MissouriMRDT/ESCBoard_Hardware/README.md

# MotorController_Hardware
New motor controllers developed for 2022 competition
Based on VESC 4.12 Motor Controllers
