MissouriMRDT/ESCBoard_Hardware/Hardware/Mocos_2021/Mocos_2021.kicad_pcb

## KiCad design Hardware/Mocos_2021/Mocos_2021.kicad_pcb (2021-08-28)

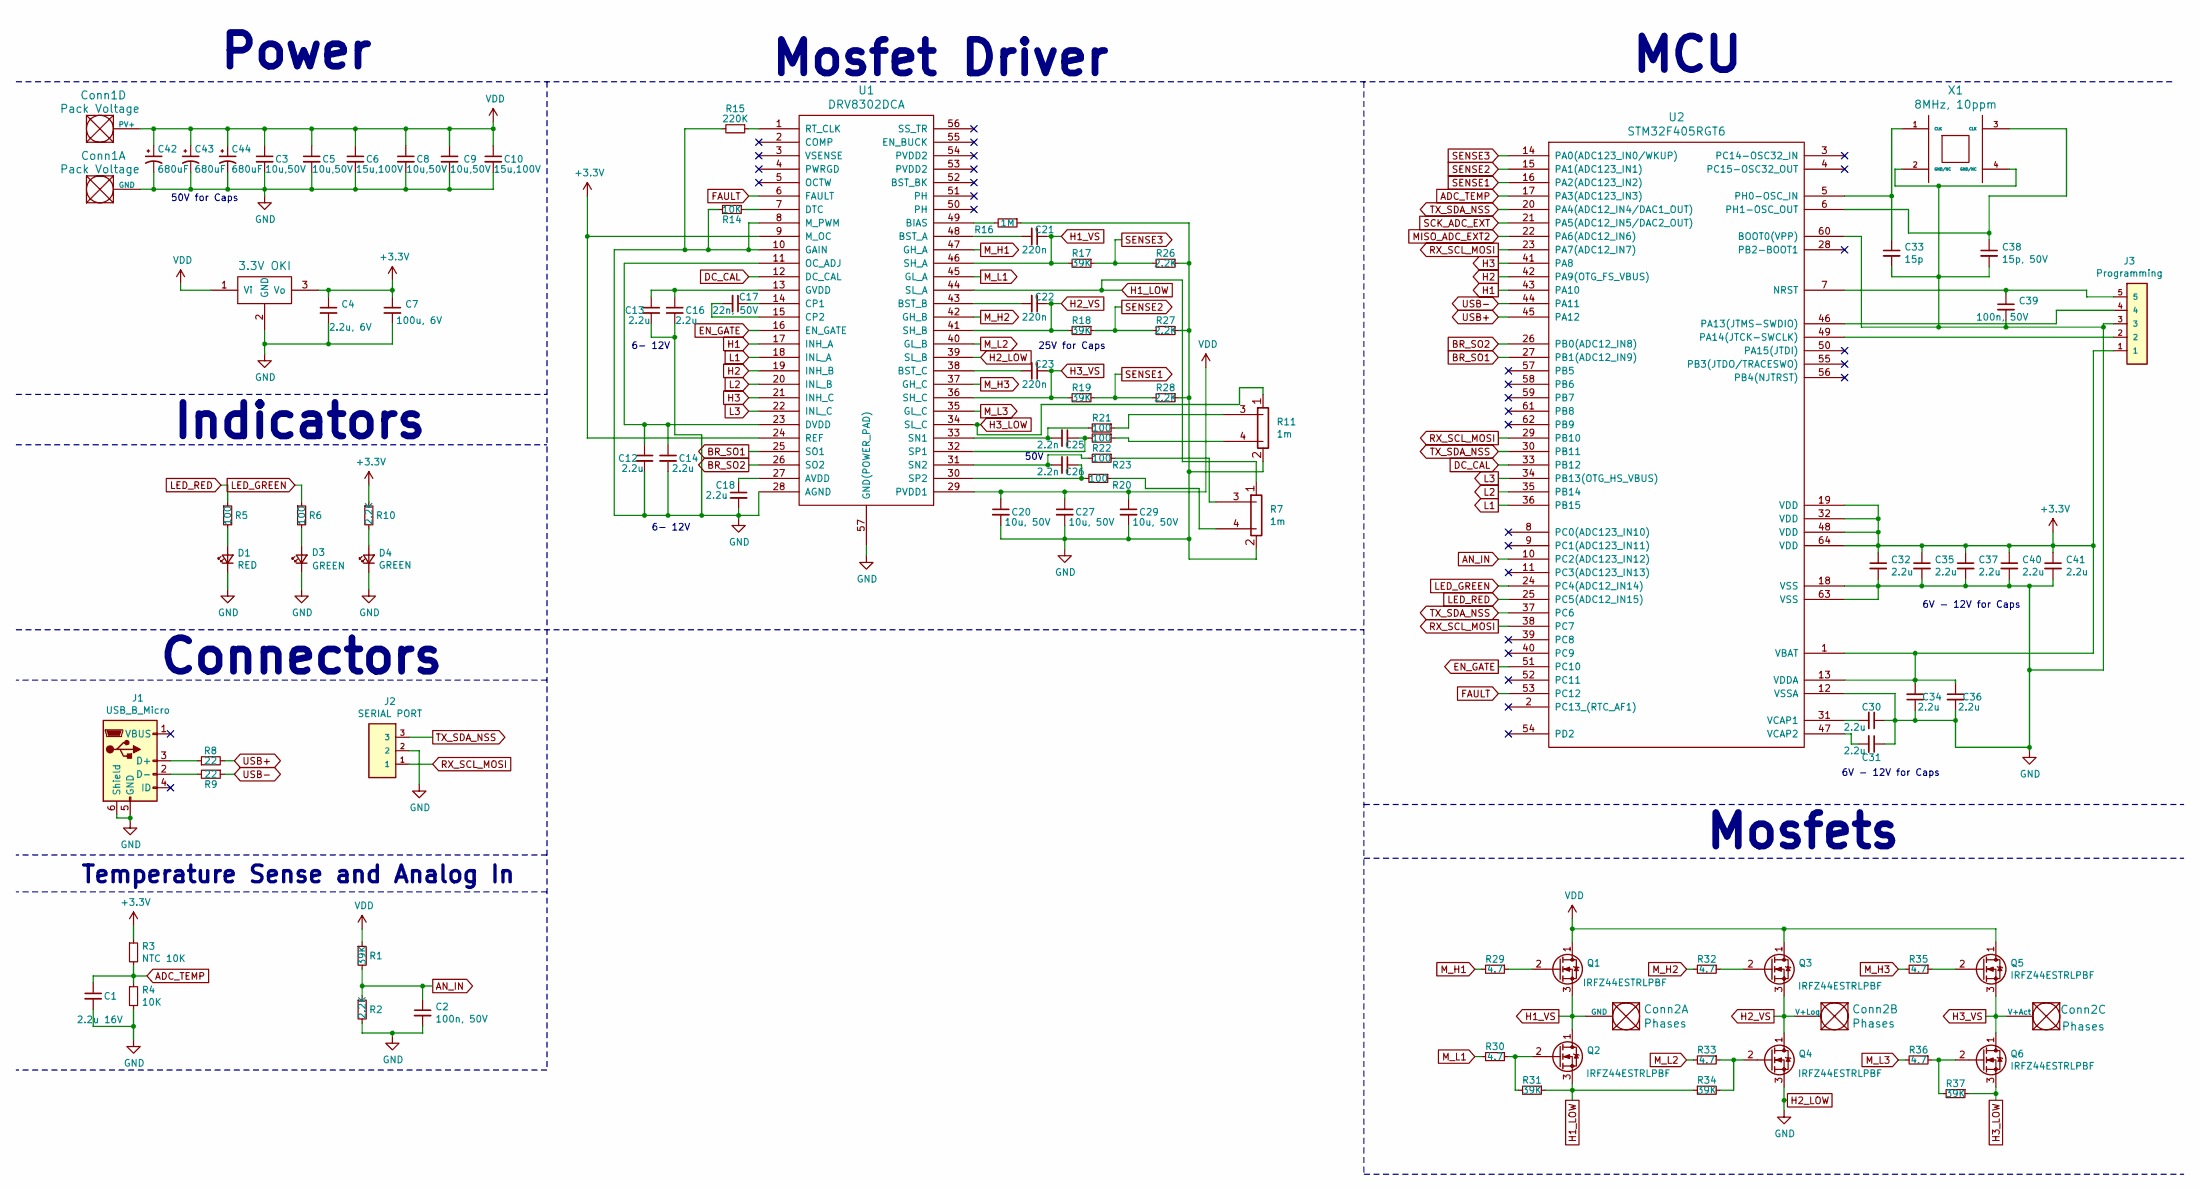
[picture p8: schematic Mocos_2021.sch, Vesc Motor Controller Rework]

Parts:
C1: 2.2u 16V; C_0402_1005Metric_Pad0.74x0.62mm_HandSolder
C2, C39: 100n, 50V; C_0603_1608Metric_Pad1.08x0.95mm_HandSolder
C3, C5, C8, C9: 10u,50V; C_1210_3225Metric_Pad1.33x2.70mm_HandSolder
C4: 2.2u, 6V; C_0402_1005Metric_Pad0.74x0.62mm_HandSolder
C6, C10: 15u,100V; C_2220_5650Metric_Pad1.97x5.40mm_HandSolder
C7: 100u, 6V; C_0805_2012Metric_Pad1.18x1.45mm_HandSolder
C12, C13, C14, C16, C18, C30, C31, C32, C34, C35, C36, C37, C40, C41: 2.2u; C_0402_1005Metric_Pad0.74x0.62mm_HandSolder
C17: 22n, 50V; C_0402_1005Metric_Pad0.74x0.62mm_HandSolder
C20, C27, C29: 10u, 50V; C_1210_3225Metric_Pad1.33x2.70mm_HandSolder
C21, C22, C23: 220n; C_0805_2012Metric_Pad1.18x1.45mm_HandSolder
C25, C26: 2.2n; C_0402_1005Metric_Pad0.74x0.62mm_HandSolder
C33: 15p; C_0603_1608Metric_Pad1.08x0.95mm_HandSolder
C38: 15p, 50V; C_0603_1608Metric_Pad1.08x0.95mm_HandSolder
C42, C43, C44: 680uF; CP_Radial_D16.0mm_P7.50mm
Conn1: Pack Voltage; Anderson_2_Horizontal_Side_by_Side_PV
Conn2: Phases; Anderson_3_Horizontal_Side_by_Side
D1: RED; LED_0603_1608Metric_Pad1.05x0.95mm_HandSolder
D3, D4: GREEN; LED_0603_1608Metric_Pad1.05x0.95mm_HandSolder
J1: USB_B_Micro; MOLEX_47346-0001
J2: SERIAL PORT; MOLEX_uF_S_03_Horizontal
J3: Programming; MOLEX_uF_S_05_Horizontal
Q1, Q2, Q3, Q4, Q5, Q6: IRFZ44ESTRLPBF
R1, R17, R18, R19, R31, R34, R37: 39K; R_0603_1608Metric_Pad0.98x0.95mm_HandSolder
R2, R10, R26, R27, R28: 2.2K; R_0603_1608Metric_Pad0.98x0.95mm_HandSolder
R3: NTC 10K; R_0603_1608Metric_Pad0.98x0.95mm_HandSolder
R4, R14: 10K; R_0603_1608Metric_Pad0.98x0.95mm_HandSolder
R5, R6, R20, R21, R22, R23: 100; R_0603_1608Metric_Pad0.98x0.95mm_HandSolder
R7, R11: 1m; WSLP2726
R8, R9: 22; R_0603_1608Metric_Pad0.98x0.95mm_HandSolder
R15: 220K; R_0603_1608Metric_Pad0.98x0.95mm_HandSolder
R16: 1M; R_0603_1608Metric_Pad0.98x0.95mm_HandSolder
R29, R30, R32, R33, R35, R36: 4.7; R_0603_1608Metric_Pad0.98x0.95mm_HandSolder
U1: DRV8302DCA; TSSOP-56-PP
U2: STM32F405RGT6; lqfp64_pad_mod
U3: 3.3V OKI; OKI_Horizontal
X1: 8MHz, 10ppm; Crystal_5x3mm

Connections:
+3V3: C4.1, C7.1, C32.1, C34.2, C35.1, C36.1, C37.1, C40.1, C41.1, J3.1, R3.1, R10.1, U1.9 (M_OC), U1.24 (REF), U2.1 (VBAT), U2.13 (VDDA), U2.19 (VDD), U2.32 (VDD), U2.48 (VDD), U2.64 (VDD), U3.3 (Vo)
ADC_TEMP: C1.1, R3.2, R4.1, U2.17 (PA3(ADC123_IN3))
AN_IN: C2.1, R1.2, R2.1, U2.10 (PC2(ADC123_IN12))
BR_SO1: U1.25 (SO1), U2.27 (PB1(ADC12_IN9))
BR_SO2: U1.26 (SO2), U2.26 (PB0(ADC12_IN8))
DC_CAL: U1.12 (DC_CAL), U2.33 (PB12)
EN_GATE: U1.16 (EN_GATE), U2.51 (PC10)
FAULT: U1.6 (FAULT), U2.53 (PC12)
H1: U1.17 (INH_A), U2.43 (PA10)
H1_LOW: Q2.3 (S), R7.1, R31.1, R34.1, U1.44 (SL_A)
H1_VS: C21.1, Conn2.1 (GND), Q1.3 (S), Q2.1 (D), R17.2, U1.46 (SH_A)
H2: U1.19 (INH_B), U2.42 (PA9(OTG_FS_VBUS))
H2_LOW: C1.2, C2.2, C3.2, C4.2, C5.2, C6.2, C7.2, C8.2, C9.2, C10.2, C12.2, C13.2, C14.2, C16.2, C18.2, C20.2, C27.2, C29.2, C30.1, C31.1, C32.2, C33.2, C34.1, C35.2, C36.2, C37.2, C38.2, C39.2, C40.2, C41.2, C42.2, C43.2, C44.2, Conn1.1 (GND), D1.1 (K), D3.1 (K), D4.1 (K), J1.5 (GND), J1.6 (Shield), J2.2, J3.3, Q4.3 (S), R2.2, R4.2, R7.2, R11.2, R14.2, R15.2, R16.1, R26.1, R27.1, R28.1, U1.8 (M_PWM), U1.10 (GAIN), U1.28 (AGND), U1.39 (SL_B), U1.57 (GND(POWER_PAD)), U2.12 (VSSA), U2.18 (VSS), U2.60 (BOOT0(VPP)), U2.63 (VSS), U3.2 (GND), X1.2 (GND/NC), X1.4 (GND/NC)
H2_VS: C22.1, Conn2.2 (V+Log), Q3.3 (S), Q4.1 (D), R18.2, U1.41 (SH_B)
H3: U1.21 (INH_C), U2.41 (PA8)
H3_LOW: Q6.3 (S), R11.1, R37.1, U1.34 (SL_C)
H3_VS: C23.1, Conn2.3 (V+Act), Q5.3 (S), Q6.1 (D), R19.2, U1.36 (SH_C)
L1: U1.18 (INL_A), U2.36 (PB15)
L2: U1.20 (INL_B), U2.35 (PB14)
L3: U1.22 (INL_C), U2.34 (PB13(OTG_HS_VBUS))
LED_GREEN: R6.1, U2.24 (PC4(ADC12_IN14))
LED_RED: R5.1, U2.25 (PC5(ADC12_IN15))
M_H1: R29.2, U1.47 (GH_A)
M_H2: R32.2, U1.42 (GH_B)
M_H3: R35.2, U1.37 (GH_C)
M_L1: R30.2, U1.45 (GL_A)
M_L2: R33.2, U1.40 (GL_B)
M_L3: R36.2, U1.35 (GL_C)
unnamed: C12.1, C14.1, U1.11 (OC_ADJ), U1.23 (DVDD)
unnamed: C13.1, C16.1, U1.13 (GVDD)
unnamed: C17.1, U1.14 (CP1)
unnamed: C17.2, U1.15 (CP2)
unnamed: C18.1, U1.27 (AVDD)
unnamed: C21.2, U1.48 (BST_A)
unnamed: C22.2, U1.43 (BST_B)
unnamed: C23.2, U1.38 (BST_C)
unnamed: C25.1, R22.2, U1.32 (SP1)
unnamed: C25.2, R21.2, U1.33 (SN1)
unnamed: C26.1, R20.2, U1.30 (SP2)
unnamed: C26.2, R23.2, U1.31 (SN2)
unnamed: C30.2, U2.31 (VCAP1)
unnamed: C31.2, U2.47 (VCAP2)
unnamed: C33.1, U2.5 (PH0-OSC_IN), X1.1 (CLK)
unnamed: C38.1, U2.6 (PH1-OSC_OUT), X1.3 (CLK)
unnamed: C39.1, J3.5, U2.7 (NRST)
unnamed: D1.2 (A), R5.2
unnamed: D3.2 (A), R6.2
unnamed: D4.2 (A), R10.2
unnamed: J1.2 (D-), R9.2
unnamed: J1.3 (D+), R8.1
unnamed: J3.2, U2.49 (PA14(JTCK-SWCLK))
unnamed: J3.4, U2.46 (PA13(JTMS-SWDIO))
unnamed: Q1.2 (G), R29.1
unnamed: Q2.2 (G), R30.1, R31.2
unnamed: Q3.2 (G), R32.1
unnamed: Q4.2 (G), R33.1, R34.2
unnamed: Q5.2 (G), R35.1
unnamed: Q6.2 (G), R36.1, R37.2
unnamed: R11.3, R21.1
unnamed: R11.4, R22.1
unnamed: R14.1, U1.7 (DTC)
unnamed: R15.1, U1.1 (RT_CLK)
unnamed: R16.2, U1.49 (BIAS)
unnamed: R7.4, R20.1
unnamed: R7.3, R23.1
RX_SCL_MOSI: J2.1, U2.23 (PA7(ADC12_IN7)), U2.29 (PB10), U2.38 (PC7)
SENSE1: R19.1, R28.2, U2.16 (PA2(ADC123_IN2))
SENSE2: R18.1, R27.2, U2.15 (PA1(ADC123_IN1))
SENSE3: R17.1, R26.2, U2.14 (PA0(ADC123_IN0/WKUP))
TX_SDA_NSS: J2.3, U2.20 (PA4(ADC12_IN4/DAC1_OUT)), U2.30 (PB11), U2.37 (PC6)
USB+: R8.2, U2.45 (PA12)
USB-: R9.1, U2.44 (PA11)
VDD: C3.1, C5.1, C6.1, C8.1, C9.1, C10.1, C20.1, C27.1, C29.1, C42.1, C43.1, C44.1, Conn1.4 (PV+), Q1.1 (D), Q3.1 (D), Q5.1 (D), R1.1, U1.29 (PVDD1), U3.1 (Vi)

Notes on the sheet:
50V for Caps
6V - 12V for Caps
6- 12V
25V for Caps
50V
Power
Mosfet Driver
MCU
Mosfets
Indicators
Connectors
Temperature Sense and Analog In

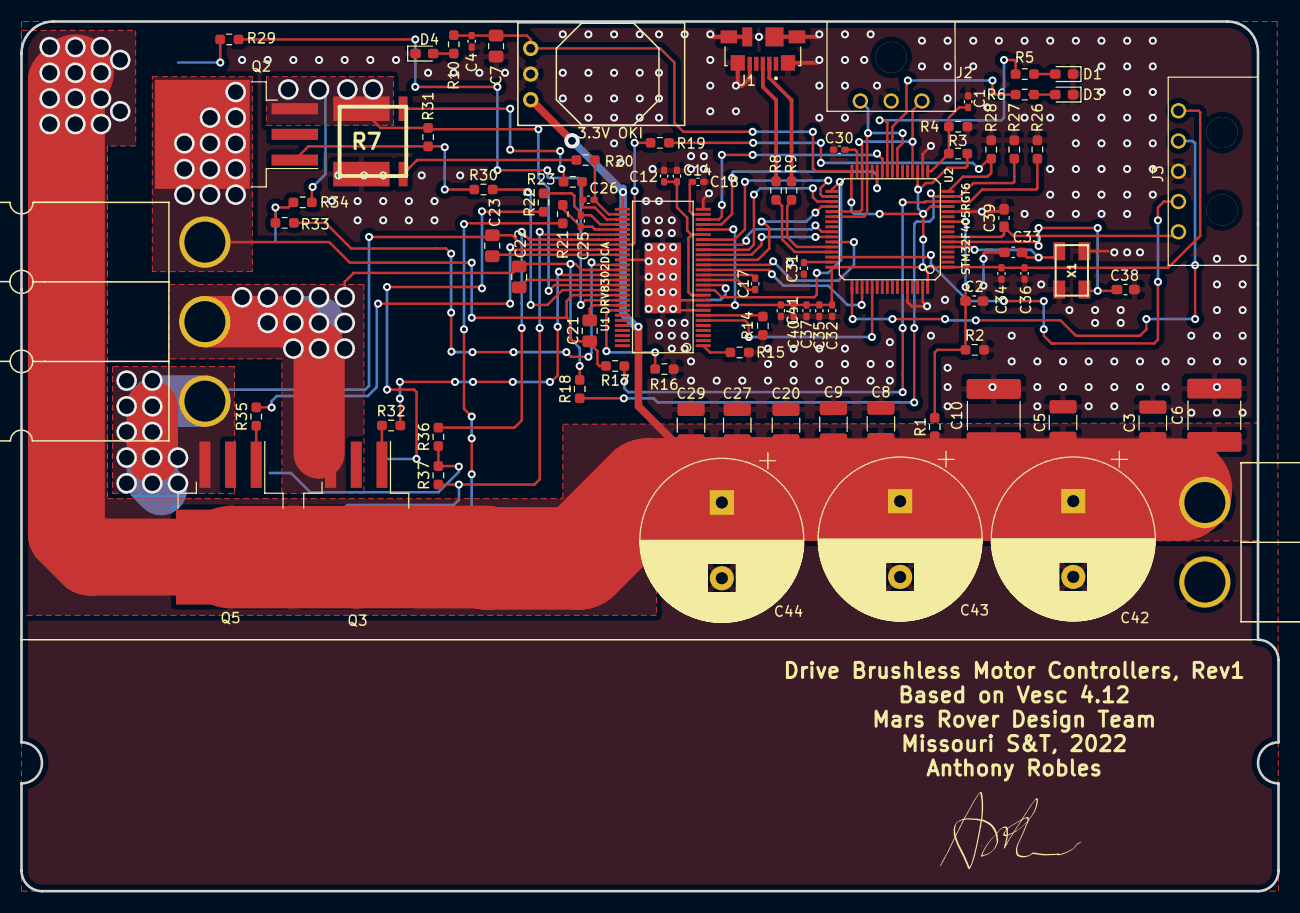
[picture p9: board Mocos_2021.kicad_pcb from above]

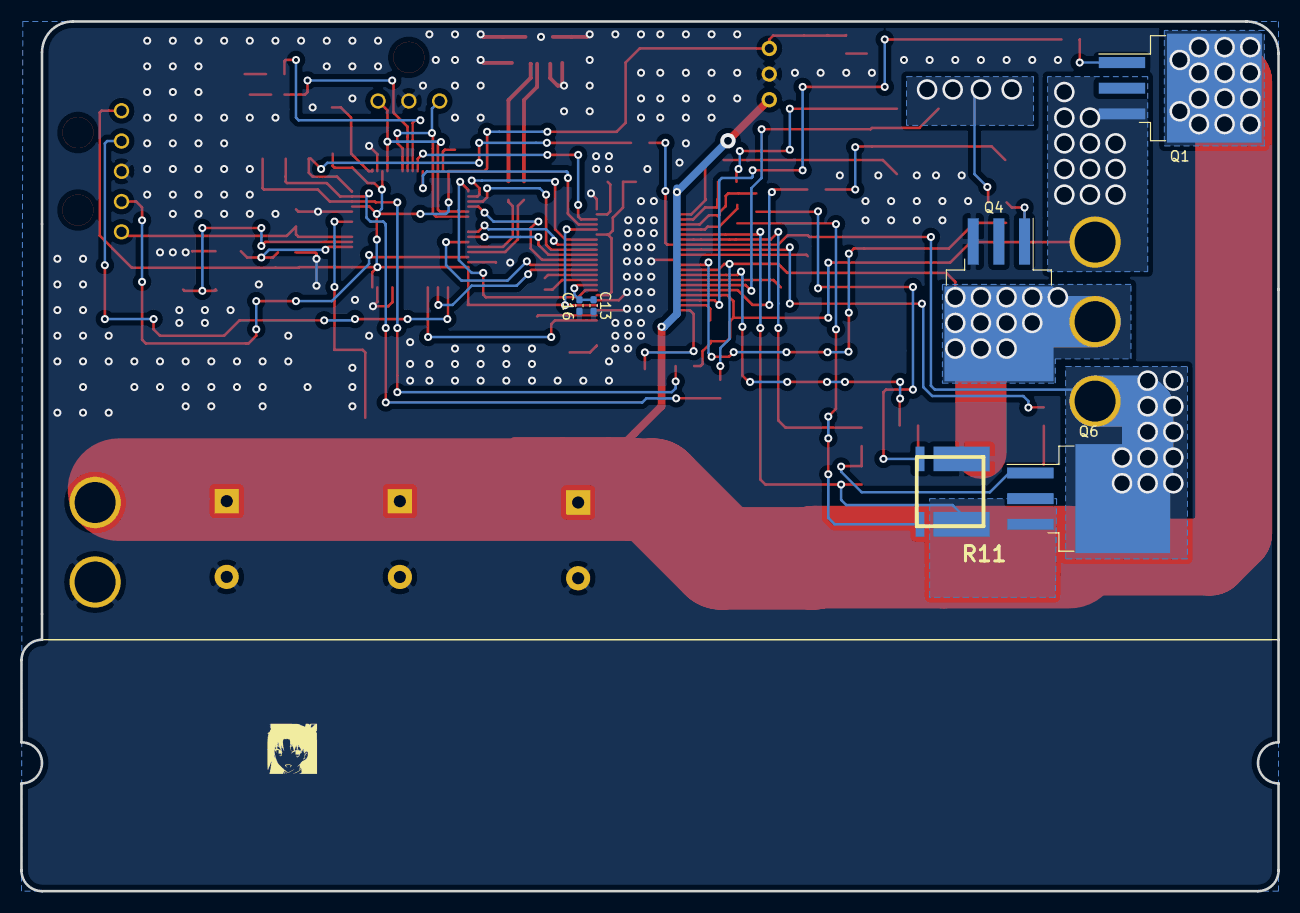
[picture p10: board Mocos_2021.kicad_pcb from below]

Board: 2 copper layers, 124.5 x 86.1 mm, 90 parts (6 on the bottom side), 73 nets.
