MissouriMRDT/ESCBoard_Hardware/(commit log)

2020-09-11 created project
    [ESC_Hardware.kicad_pcb, ESC_Hardware.sch]
2020-10-09 Added Libraries, Began Microcontroller sheet
    [ESCBoard_01.sch, ESC_Hardware.sch]
2020-10-12 finished schematic
    [CAN.sch, ESCBoard_02.sch, ESCBoard_03.sch]
2021-03-19 Added Rev4.1 for reference
    [BLDC4.12_BOM.ods, BLDC_4-2021-02-16-14-32-30.sch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]
2021-08-18 Added Schematic and working on Layout
    [BLDC4.12_BOM.ods, BLDC_4-2021-02-16-14-32-30.sch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]
2021-08-19 Added footprints to board
    [Mocos_2021.sch]
2021-08-21 Finished STM32 Layout
    [Mocos_2021.kicad_pcb, Mocos_2021.sch]
2021-08-21 Added 3.3V Oki for cleaner layout
    [Mocos_2021.kicad_pcb, Mocos_2021.sch]
2021-08-24 Retraced the entire VDD Net and readjusted the Mosfet placement
    [Mocos_2021.kicad_pcb]
2021-08-24 Moved Q6 to a better position for Routing
    [Mocos_2021.kicad_pcb]
2021-08-24 Finished routing all but the sense resistors
    [Mocos_2021.kicad_pcb]
2021-08-25 Finished layout and generated Gerbs
    [Mocos_2021-B_Cu.gbr, Mocos_2021-B_Mask.gbr, Mocos_2021-B_Paste.gbr, Mocos_2021-B_SilkS.gbr, Mocos_2021-Edge_Cuts.gbr, Mocos_2021-F_Cu.gbr, Mocos_2021-F_Mask.gbr, Mocos_2021-F_Paste.gbr]
2021-08-28 Finished BOM and Fixed some Layout errors such as trace tolerance
    [Mocos_2021-B_Cu.gbr, Mocos_2021-B_Mask.gbr, Mocos_2021-B_Paste.gbr, Mocos_2021-B_SilkS.gbr, Mocos_2021-Edge_Cuts.gbr, Mocos_2021-F_Cu.gbr, Mocos_2021-F_Mask.gbr, Mocos_2021-F_Paste.gbr]
